tesla5hundred/6MS/Hardware/Master Board/Production Package/Readme.txt

****CONTACT/SHIPPING INFORMATION
David Kronstein
Kron Technologies Inc.
113-8337 Eastlake Drive
Burnaby, BC
Canada V5A 4W2

dkronstein@krontech.ca
604 908 4253
 
****ORDER INFORMATION:

Quantity: 			10

****BOARD INFORMATION:
Material:			FR4
Board Dimensions		94mm x 42.5mm
Number of layers		2
Smallest hole 			0.8mm
Largest hole			3.175mm
Slotted Holes			2 locations
Minimum Trace			0.2mm
Minimum Space			0.2mm

Finished Board Thickness: 	1.6mm
Copper Thickness: 		1.0 oz (35um) Finished (outer layers)
Controlled Impedance:		No
Solder mask:			Top and bottom, Blue color
Silkscreen:			Top and bottom, White color
Plating:			HASL
Electrical Test:		Yes

****INCLUDED FILES:
Note: All Gerbers are in metric units
 
Readme.TXT 			This file

Local Master.GTL		Gerber, Top Layer
Local Master.GBL		Gerber, Bottom Layer
Local Master.GTO		Gerber, Top Ovelay silkscreen
Local Master.GTS		Gerber, Top Solder mask
Local Master.GBS		Gerber, Bottom Solder mask
Local Master.GTP		Gerber, Top Solder paste
Local Master.GBP		Gerber, Bottom Solder paste

Local Master.GM1		Gerber, Board outline routing
Local Master.gd1		Drill file
Local Master.gg1		Drill guide

Local Master.TXT		NC Drill: Excellon drill file

Pick Place for Local Master(Three Resistor).txt
				Pick and place data
