tesla5hundred/6MS/Hardware/Master Board/PLL Calcs.xlsx

fIn | 7.37 |  | fOut | 40
 | N1 |  |  |  | N1 2 to 9 | N2 | 2
M | 2 | 3 | 4 | 5 | 6 | 7 | 8 | 9
2 | 3.685 | 2.456666667 | 1.8425 | 1.474 | 1.228333333 | 1.052857143 | 0.92125 | 0.8188888889
3 | 5.5275 | 3.685 | 2.76375 | 2.211 | 1.8425 | 1.579285714 | 1.381875 | 1.228333333
4 | 7.37 | 4.913333333 | 3.685 | 2.948 | 2.456666667 | 2.105714286 | 1.8425 | 1.637777778
5 | 9.2125 | 6.141666667 | 4.60625 | 3.685 | 3.070833333 | 2.632142857 | 2.303125 | 2.047222222
6 | 11.055 | 7.37 | 5.5275 | 4.422 | 3.685 | 3.158571429 | 2.76375 | 2.456666667
7 | 12.8975 | 8.598333333 | 6.44875 | 5.159 | 4.299166667 | 3.685 | 3.224375 | 2.866111111
8 | 14.74 | 9.826666667 | 7.37 | 5.896 | 4.913333333 | 4.211428571 | 3.685 | 3.275555556
9 | 16.5825 | 11.055 | 8.29125 | 6.633 | 5.5275 | 4.737857143 | 4.145625 | 3.685
10 | 18.425 | 12.28333333 | 9.2125 | 7.37 | 6.141666667 | 5.264285714 | 4.60625 | 4.094444444
11 | 20.2675 | 13.51166667 | 10.13375 | 8.107 | 6.755833333 | 5.790714286 | 5.066875 | 4.503888889
12 | 22.11 | 14.74 | 11.055 | 8.844 | 7.37 | 6.317142857 | 5.5275 | 4.913333333
13 | 23.9525 | 15.96833333 | 11.97625 | 9.581 | 7.984166667 | 6.843571429 | 5.988125 | 5.322777778
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
