tesla5hundred/6MS/Hardware/Master Board/Production Package/BOM/Bill of Materials-Local Master(Three Resistor).xls

Sheet: BOM Report
 | Kron Technologies 304 East 8th Avenue New Westminster, BC Canada, V3L 4K6 |  |  |  |  | Bill of Materials
 | Project: | Local Master.PrjPCB
 | PCB Name: | <Parameter Project not found>
 | Revision: | <Parameter Rev not found>
 | Variant: | Three Resistor |  |  |  | Multiple Factor: | 1 | Set(s)
 | PO#:
 | Creation Date: | 2021-01-11
Item # | Description | Designator | Item Number | Footprint | Dist | Dist P/N | Mfg | Mfgr P/N | Price | Quantity | Total Price
1 | Cap Ceramic 0.1u 25V X7R 0603 | C1, C2, C3, C6, C9, C10, C11, C12, C13, C16, C19, C21, C24, C25, C27, C28, C35, C36 |  | CAPC1608N-0603 | Digi-Key | 399-1281-1-ND | Kemet | C0603C104K3RACTU | 0.079 | 18 | $1.42
2 | Cap Ceramic 10n 50V X7R 0603 | C4 |  | CAPC1608N-0603 | Digi-Key | 445-1348-1-ND | TDK | C1608X7R1H103J | 0.047 | 1 | $0.05
3 | Cap Ceramic 0.1u 50V X7R 0603 | C7, C8, C17 |  | CAPC1608N-0603 | Digi-Key | 311-1344-1-ND | Yageo | CC0603KRX7R9BB104 | 0.35 | 3 | $1.05
4 | Cap Ceramic 1u 25V X5R 0603 | C14, C15, C18, C20, C29, C30 |  | CAPC1608N-0603 | Digi-Key | 445-5146-1-ND | TDK | C1608X5R1E105K | 0.093 | 6 | $0.56
5 | Cap Ceramic 20p 50V C0G 0603 | C22, C23 |  | CAPC1608N-0603 | Digi-Key | 490-1410-1-ND | Murata | GRM1885C1H200JA01D | 0.06 | 2 | $0.12
6 | Cap Ceramic 10u 6.3V X5R 0603 | C26, C32 |  | CAPC1608N-0603 | Digi-Key | 445-4112-1-ND | TDK | C1608X5R0J106M | 0.46 | 2 | $0.92
7 | Cap Ceramic 1u 50V X5R 0603 | C33 |  | CAPC1608N-0603 | Digi-Key | 1276-1860-1-ND | Samsung Electro-Mechanics | CL10A105KB8NNNC | 0.28 | 1 | $0.28
8 | Cap Ceramic 100pF 50V C0G 0402 | C34 |  | CAPC1608N-0603 | Digi-Key | 445-5596-1-ND | TDK | CGA2B2C0G1H101J050BA | 0.15 | 1 | $0.15
9 | Diode Zener 24V 0.5W SOD-123 | D2 |  | SOD-123 | Digi-Key | MMSZ5252B-TPMSCT-ND | MCC | MMSZ5252B-TP | 0.40 | 1 | $0.40
10 | Diode Schottky 200mA 30V Series SOT-23 | D3, D4 |  | SOT23-3N | Digi-Key | 568-1614-1-ND | NXP Semiconductors | BAT54S,215 | 0.47 | 2 | $0.94
11 | Diode Zener 10V 0.5W SOD-123 | D5, D6, D7 |  | SOD-123 | Digi-Key | BZT52C10-TPMSCT-ND | MCC | BZT52C10-TP | 0.38 | 3 | $1.14
12 | LED Red 160° 0603 | D8 |  | CAPC1608N-0603 | Digi-Key | 475-3016-1-ND | Osram | LS Q971-KN-1 | 0.08 | 1 | $0.08
13 | LED Green 160° 0603 | D9 |  | CAPC1608N-0603 | Digi-Key | 475-1409-1-ND | Osram | LG Q971-KN-1 | 0.11 | 1 | $0.11
14 | Fuse PTC 50mA 60V 1206 | F8, F9, F10 |  | RESC3216N-1206 | Digi-Key | 507-1476-1-ND | Bel Fuse | 0ZCA0005FF2E | 0.28 | 3 | $0.84
15 | Conn Header 2.5mm Vert 2-Pos EH | J1, J2 |  | B2B-EH | Digi-Key | 455-1611-ND | JST | B2B-EH-A(LF)(SN) | 0.13 | 2 | $0.26
16 | Conn Header 1.5mm Vert 5-Pos ZH | J3 |  | B5B-ZR | Digi-Key | 455-1660-ND | JST | B5B-ZR(LF)(SN) | 0.2 | 1 | $0.20
17 | Conn Header 2.5mm Vert 4-Pos EH | J5 |  | B4B-EH | Digi-Key | 455-1613-ND | JST | B4B-EH-A(LF)(SN) | 0.19 | 1 | $0.19
18 | Conn Header 2.5mm Vert 8-Pos EH | J6 |  | B8B-EH | Digi-Key | 455-1617-ND | JST | B8B-EH-A(LF)(SN) | 0.32 | 1 | $0.32
19 | Conn Header 1.5mm Vert 2-Pos ZH | J7 |  | B2B-ZR | Digi-Key | 455-1657-ND | JST | B2B-ZR(LF)(SN) | 0.11 | 1 | $0.11
20 | Ind Bead 600R 1A 0603 | L1 |  | INDC1608N-0603 | Digi-Key | 240-2371-1-ND | Laird | MI0603J601R-10 | 0.087 | 1 | $0.09
21 | Ind 1mH 90mA SDR0403-102KL | L2 |  | SDR0403 | Digi-Key | SDR0403-102KLCT-ND | Bourns | SDR0403-102KL | 0.69 | 1 | $0.69
22 | Tran PNP Darl 30V 500mA SOT-23 | Q1, Q3, Q6, Q8, Q10, Q12 |  | SOT23-3N | Digi-Key | MMBTA64-FDICT-ND | Diodes Inc | MMBTA64-7-F | 0.27 | 6 | $1.62
23 | Tran NPN 40V 200mA SOT-23 | Q2, Q4, Q5, Q7, Q9, Q11, Q13 |  | SOT23-3N | Digi-Key | MMBT3904FSCT-ND | Fairchild | MMBT3904 | 0.37 | 7 | $2.59
24 | Tran N-MOSFET 60V 115mA SOT-23 | Q14 |  | SOT23-3N | Digi-Key | 2N7002NCT-ND | Fairchild Semiconductor | 2N7002 | 0.56 | 1 | $0.56
25 | Res 499K 1/10W 1% 0603 | R1, R5, R17, R23, R36, R41, R53, R63, R114 |  | RESC1608N-0603 | Digi-Key | P499KHCT-ND | Panasonic | ERJ-3EKF4993V | 0.05 | 9 | $0.45
26 | Res 10.0K 1/10W 1% 0603 | R2, R6, R9, R20, R22, R24, R37, R38, R40, R52, R54, R55, R56, R68, R69, R81, R84, R92, R93, R94, R99, R104, R109, R112, R113 |  | RESC1608N-0603 | Digi-Key | P10.0KHCT-ND | Panasonic | ERJ-3EKF1002V | 0.05 | 25 | $1.25
27 | Res 100K 1/10W 1% 0603 | R3, R18, R34, R50, R51, R66, R67, R76, R77, R82, R83, R100, R101, R105, R106 |  | RESC1608N-0603 | Digi-Key | P100KHCT-ND | Panasonic | ERJ-3EKF1003V | 0.05 | 15 | $0.75
28 | Res 280K 1/10W 1% 0603 | R4, R19, R35, R80 |  | RESC1608N-0603 | Digi-Key | P280KHCT-ND | Panasonic | ERJ-3EKF2803V | 0.05 | 4 | $0.20
29 | Res 200K 1/10W 1% 0603 | R7, R10, R25, R27, R48, R49, R64, R65 |  | RESC1608N-0603 | Digi-Key | P200KHCT-ND | Panasonic | ERJ-3EKF2003V | 0.05 | 8 | $0.40
30 | Res 1.00K 1/10W 1% 0603 | R8 |  | RESC1608N-0603 | Digi-Key | P1.00KHCT-ND | Panasonic | ERJ-3EKF1001V | 0.05 | 1 | $0.05
31 | Res 121R 1/4W 1% 1206 | R11, R12, R13, R28, R29, R30, R42, R43, R44, R57, R58, R59, R70, R71, R72, R85, R86, R87, R91 |  | RESC3216N-1206 | Digi-Key | P121FCT-ND | Panasonic | ERJ-8ENF1210V | 0.10 | 19 | $1.90
32 | Res 31.6K 1/10W 1% 0603 | R14 |  | RESC1608N-0603 | Digi-Key | P31.6KHCT-ND | Panasonic | ERJ-3EKF3162V | 0.05 | 1 | $0.05
33 | Res 2.32K 1/10W 1% 0603 | R21 |  | RESC1608N-0603 | Digi-Key | P2.32KHCT-ND | Panasonic | ERJ-3EKF2321V | 0.05 | 1 | $0.05
34 | Res 4.99K 1/10W 1% 0603 | R26 |  | RESC1608N-0603 | Digi-Key | P4.99KHCT-ND | Panasonic | ERJ-3EKF4991V | 0.05 | 1 | $0.05
35 | Res 120R 1/10W 1% 0603 | R39, R107, R108, R110 |  | RESC1608N-0603 | Digi-Key | P120HCT-ND | Panasonic | ERJ-3EKF1200V | 0.05 | 4 | $0.20
36 | Res 3.32K 1/10W 1% 0603 | R78 |  | RESC1608N-0603 | Digi-Key | P3.32KHCT-ND | Panasonic | ERJ-3EKF3322V | 0.05 | 1 | $0.05
37 | Res 150K 1/10W 1% 0603 | R79 |  | RESC1608N-0603 | Digi-Key | P150KHCT-ND | Panasonic | ERJ-3EKF1503V | 0.05 | 1 | $0.05
38 | Res 499R 1/10W 1% 0603 | R95, R96 |  | RESC1608N-0603 | Digi-Key | P499HCT-ND | Panasonic | ERJ-3EKF4990V | 0.05 | 2 | $0.10
39 | Res 66.5K 1/10W 1% 0603 | R97, R102 |  | RESC1608N-0603 | Digi-Key | P66.5KHCT-ND | Panasonic | ERJ-3EKF6652V | 0.05 | 2 | $0.10
40 | Res 100R 1/10W 1% 0603 | R98, R103 |  | RESC1608N-0603 | Digi-Key | P100HCT-ND | Panasonic | ERJ-3EKF1000V | 0.05 | 2 | $0.10
41 | IC Op-Amp Low Power RRIO 32V 14-SOIC | U1 |  | SOIC127P600-14N | Digi-Key | 296-17953-1-ND | TI | LP324DR | 0.62 | 1 | $0.62
42 | IC Optocoupler Bi-Di LED 80-300% SOIC4 | U2 |  | MFP127P4.4-4 | Digikey | 751-1374-1-ND | Vishay | TCMT1600 | 0.73 | 1 | $0.73
43 | IC Voltage Reg LDO 5V SOT-23-5 | U4 |  | SOT23-5N | Digi-Key | MCP1804T-5002I/OTCT-ND | Microchip | MCP1804T-5002I/OT | 0.80 | 1 | $0.80
44 | IC Driver CAN 8-SOIC | U5 |  | SMD-8 | Digi-Key | 296-24818-1-ND | TI | ISO1050DUBR | 4.02 | 1 | $4.02
45 | IC ESD Protector CAN SOT23 | U6 |  | SOT23-3N | Digi-Key | 568-4032-1-ND | NXP | PESD1CAN,215 | 0.44 | 1 | $0.44
46 | IC ADC I2C 16-Bit 15SPS SOT23-6 | U7 |  | SOT23-6N | Digikey | MCP3425A0T-E/CHCT-ND | Microchip | MCP3425A0T-E/CH | 2.60 | 1 | $2.60
47 | IC Op-Amp Low Power RRIO 32V 8-SOIC | U8 |  | SOIC127P600-8N | Mouser | 595-LP358DR | Texas Instruments | LP358DR | 0.642 | 1 | $0.64
48 | IC Micro DSPIC33EP128GP504-I/PT 44-TQFP | U9 |  | TQFP44-0.8 | Digi-Key | DSPIC33EP128GP504-I/PT-ND | Microchip | DSPIC33EP128GP504-I/PT | 3.70 | 1 | $3.70
49 | IC Voltage Ref 2.048V 0.3% uPwr SOT-23 | U10 |  | SOT23-3N | Digi-Key | ISL21080CIH320Z-TKCT-ND | Intersil | ISL21080CIH320Z-TK | 1.69 | 1 | $1.69
50 | IC Reg Buck 4.7-60V 50mA 8-MSOP | U11 |  | MSOP65P3.0-8N | Digi-Key | 296-28780-1-ND | TI | TPS54062DGKR | 2.25 | 1 | $2.25
51 | IC Mem EEPROM 16Kb (2K x 8) I2C SOT-23-5 | U12 |  | SOT23-5N | Digikey | 24LC16BT-I/OTCT-ND | Microchip | 24LC16BT-I/OT | 0.38 | 1 | $0.38
 |  |  |  |  |  |  |  |  | TOTAL: |  | $38.31
 | Approved |  |  |  | Notes

Sheet: Project Information
Project Full Path | C:\Work\6MS\Hardware\Master Board\Local Master.PrjPCB
Project Filename | Local Master.PrjPCB
Variant Name | Three Resistor
Data-Source Filename | Local Master.PrjPCB
Data-Source Full Path | C:\Work\6MS\Hardware\Master Board\Local Master.PrjPCB
Title | Bill of Materials for Variant [Three Resistor] of Project [Local Master.PrjPCB] (No PCB Document Selected)
Total Quantity | 174
Report Time | 17:22
Report Date | 2021-01-11
Report Date & Tine | 2021-01-11 17:22
Output Name | Bill of Materials
Output Type | BOM_PartType
Output Generator Name | BOM
Output Generator Description | Bill of Materials
