tesla5hundred/6MS/Hardware/Slave Board/Production Package/BOM/Bill of Materials-Balance Board(Three Resistors).xls

Sheet: BOM Report
 | Kron Technologies 304 East 8th Avenue New Westminster, BC Canada, V3L 4K6 |  |  |  |  | Bill of Materials
 | Project: | Balance Board.PrjPCB
 | PCB Name: | <Parameter Project not found>
 | Revision: | <Parameter Rev not found>
 | Variant: | Three Resistors |  |  |  | Multiple Factor: | 1 | Set(s)
 | PO#:
 | Creation Date: | 2021-01-11
Item # | Description | Designator | Item Number | Footprint | Dist | Dist P/N | Mfg | Mfgr P/N | Price | Quantity | Total Price
1 | Cap Ceramic 0.1u 25V X7R 0603 | C1, C2, C3, C4, C5, C6, C8, C9, C10 |  | CAPC1608N-0603 | Digi-Key | 399-1281-1-ND | Kemet | C0603C104K3RACTU | 0.079 | 9 | $0.71
2 | Cap Ceramic 0.1u 50V X7R 0603 | C7 |  | CAPC1608N-0603 | Digi-Key | 311-1344-1-ND | Yageo | CC0603KRX7R9BB104 | 0.35 | 1 | $0.35
3 | Diode Zener 10V 0.5W SOD-123 | D1 |  | SOD-123 | Digi-Key | BZT52C10-TPMSCT-ND | MCC | BZT52C10-TP | 0.38 | 1 | $0.38
4 | LED Green 160° 0603 | D2 |  | CAPC1608N-0603 | Digi-Key | 475-1409-1-ND | Osram | LG Q971-KN-1 | 0.11 | 1 | $0.11
5 | Conn Header 2.5mm RA 2-Pos EH | J1, J2 |  | S2B-EH | Digi-Key | 455-1625-ND | JST | S2B-EH(LF)(SN) | 0.16 | 2 | $0.32
6 | Conn Header 1.5mm Vert 5-Pos ZH | J3 |  | B5B-ZR | Digi-Key | 455-1660-ND | JST | B5B-ZR(LF)(SN) | 0.2 | 1 | $0.20
7 | Tran PNP Darl 30V 500mA SOT-23 | Q1, Q3, Q6, Q8, Q10, Q12 |  | SOT23-3N | Digi-Key | MMBTA64-FDICT-ND | Diodes Inc | MMBTA64-7-F | 0.27 | 6 | $1.62
8 | Tran NPN 40V 200mA SOT-23 | Q2, Q4, Q5, Q7, Q9, Q11, Q13 |  | SOT23-3N | Digi-Key | MMBT3904FSCT-ND | Fairchild | MMBT3904 | 0.37 | 7 | $2.59
9 | Res 499K 1/10W 1% 0603 | R1, R5, R17, R23, R36, R41, R53, R63 |  | RESC1608N-0603 | Digi-Key | P499KHCT-ND | Panasonic | ERJ-3EKF4993V | 0.05 | 8 | $0.40
10 | Res 10.0K 1/10W 1% 0603 | R2, R6, R9, R20, R22, R24, R37, R38, R40, R52, R54, R55, R56, R68, R69, R81, R84 |  | RESC1608N-0603 | Digi-Key | P10.0KHCT-ND | Panasonic | ERJ-3EKF1002V | 0.05 | 17 | $0.85
11 | Res 100K 1/10W 1% 0603 | R3, R18, R34, R50, R51, R66, R67, R76, R77, R82, R83 |  | RESC1608N-0603 | Digi-Key | P100KHCT-ND | Panasonic | ERJ-3EKF1003V | 0.05 | 11 | $0.55
12 | Res 280K 1/10W 1% 0603 | R4, R19, R35, R80 |  | RESC1608N-0603 | Digi-Key | P280KHCT-ND | Panasonic | ERJ-3EKF2803V | 0.05 | 4 | $0.20
13 | Res 200K 1/10W 1% 0603 | R7, R10, R25, R27, R48, R49, R64, R65 |  | RESC1608N-0603 | Digi-Key | P200KHCT-ND | Panasonic | ERJ-3EKF2003V | 0.05 | 8 | $0.40
14 | Res 1.00K 1/10W 1% 0603 | R8 |  | RESC1608N-0603 | Digi-Key | P1.00KHCT-ND | Panasonic | ERJ-3EKF1001V | 0.05 | 1 | $0.05
15 | Res 121R 1/4W 1% 1206 | R14, R15, R16, R31, R32, R33, R45, R46, R47, R60, R61, R62, R73, R74, R75, R88, R89, R90 |  | RESC3216N-1206 | Digi-Key | P121FCT-ND | Panasonic | ERJ-8ENF1210V | 0.10 | 18 | $1.80
16 | Res 2.32K 1/10W 1% 0603 | R21 |  | RESC1608N-0603 | Digi-Key | P2.32KHCT-ND | Panasonic | ERJ-3EKF2321V | 0.05 | 1 | $0.05
17 | Res 4.99K 1/10W 1% 0603 | R26 |  | RESC1608N-0603 | Digi-Key | P4.99KHCT-ND | Panasonic | ERJ-3EKF4991V | 0.05 | 1 | $0.05
18 | Res 120R 1/10W 1% 0603 | R39 |  | RESC1608N-0603 | Digi-Key | P120HCT-ND | Panasonic | ERJ-3EKF1200V | 0.05 | 1 | $0.05
19 | Res 3.32K 1/10W 1% 0603 | R78 |  | RESC1608N-0603 | Digi-Key | P3.32KHCT-ND | Panasonic | ERJ-3EKF3322V | 0.05 | 1 | $0.05
20 | Res 150K 1/10W 1% 0603 | R79 |  | RESC1608N-0603 | Digi-Key | P150KHCT-ND | Panasonic | ERJ-3EKF1503V | 0.05 | 1 | $0.05
21 | IC Op-Amp Low Power RRIO 32V 14-SOIC | U1 |  | SOIC127P600-14N | Digi-Key | 296-17953-1-ND | TI | LP324DR | 0.62 | 1 | $0.62
22 | IC Optocoupler Bi-Di LED 80-300% SOIC4 | U2 |  | MFP127P4.4-4 | Digikey | 751-1374-1-ND | Vishay | TCMT1600 | 0.73 | 1 | $0.73
23 | IC Voltage Reg LDO 3.3V SOT-23 | U3 |  | SOT23-3N | Digi-Key | MCP1702T-3302E/CBCT-ND | Microchip | MCP1702T-3302E/CB | 0.59 | 1 | $0.59
24 | IC Micro PIC16F1829 20-SSOP | U4 |  | SOP65P780X200-20N | Digi-Key | PIC16F1829-I/SS-ND | Microchip | PIC16F1829-I/SS | 1.74 | 1 | $1.74
 |  |  |  |  |  |  |  |  | TOTAL: |  | $14.46
 | Approved |  |  |  | Notes

Sheet: Project Information
Project Full Path | C:\Work\6MS\Hardware\Slave Board\Balance Board.PrjPCB
Project Filename | Balance Board.PrjPCB
Variant Name | Three Resistors
Data-Source Filename | Balance Board.PrjPCB
Data-Source Full Path | C:\Work\6MS\Hardware\Slave Board\Balance Board.PrjPCB
Title | Bill of Materials for Variant [Three Resistors] of Project [Balance Board.PrjPCB] (No PCB Document Selected)
Total Quantity | 104
Report Time | 16:46
Report Date | 2021-01-11
Report Date & Tine | 2021-01-11 16:46
Output Name | Bill of Materials
Output Type | BOM_PartType
Output Generator Name | BOM
Output Generator Description | Bill of Materials
