tesla5hundred/6MS/(list of files, cad)

Other CAD files:
Software/6MSSlave.X/l.obj
