tesla5hundred/6MS/Hardware/Master Board/Production Package/Assembley Readme.txt

Populate 10 boards according to Bill of Materials-Local Master(Three Resistor).xls
