tesla5hundred/6MS/Hardware/Slave Board/Production Package/Assembley Readme.txt

Populate 40 boards according to Bill of Materials-Balance Board(Three Resistors).xls
