tesla5hundred/6MS/(list of files, drawings)

Other design files:
Hardware/6MS.PcbLib
Hardware/6MS.SchLib
Hardware/Master Board/Local Master.PcbDoc
Hardware/Master Board/Local Master.PrjPCB
Hardware/Master Board/Local Master.SchDoc
Hardware/Slave Board/Balance Board.PcbDoc
Hardware/Slave Board/Balance Board.PrjPCB
Hardware/Slave Board/Balance Board.SchDoc
