tesla5hundred/6MS/Software/6MSM.X/ADC.h

/* 
 * File:   ADC.h
 * Author: User
 *
 * Created on December 8, 2013, 5:17 PM
 */

#ifndef ADC_H
#define	ADC_H

#ifdef	__cplusplus
extern "C" {
#endif

#include "types.h"

int initADC(void);
int readADC(void);


#ifdef	__cplusplus
}
#endif

#endif	/* ADC_H */
