tesla5hundred/6MS/(commit log)

2021-01-09 Initial commit of project
    [Balance Board.PcbDoc, Balance Board.PrjPCB, Balance Board.SchDoc, Local Master.PcbDoc, Local Master.PrjPCB, Local Master.SchDoc, PLL Calcs.xlsx, l.obj]
2021-01-10 Revision to fix errors from rev 1.
    - Fixed incorrect transistor pinout for load switches
    - Replaced linear power supply with buck converter for lower power draw
    - Removed half the load resistors, now 100mA load instead of 200, higher load wasn't needed
    - Added library for new and updated components
    - Updated PCB layout with these changes
    [6MS.PcbLib, 6MS.SchLib, Local Master.PcbDoc, Local Master.PrjPCB, Local Master.SchDoc]
2021-01-12 Various minor changes for production, added production package for slave board
    [Balance Board.GBL, Balance Board.GBO, Balance Board.GBP, Balance Board.GBS, Balance Board.GM1, Balance Board.GTL, Balance Board.GTO, Balance Board.GTP]
2021-01-12 Minor changes for production, added production packages for Rev 2
    [Bill of Materials-Local Master(Three Resistor).xls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]
2021-01-13 Updated master board and production package to add missing bottom soldermask layer in production package, fixed some vias that were not tented.
    [Local Master.PcbDoc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]
